Dylan0623/Rematch_in_2019/升压电路/升压模块12V转15V.pdf

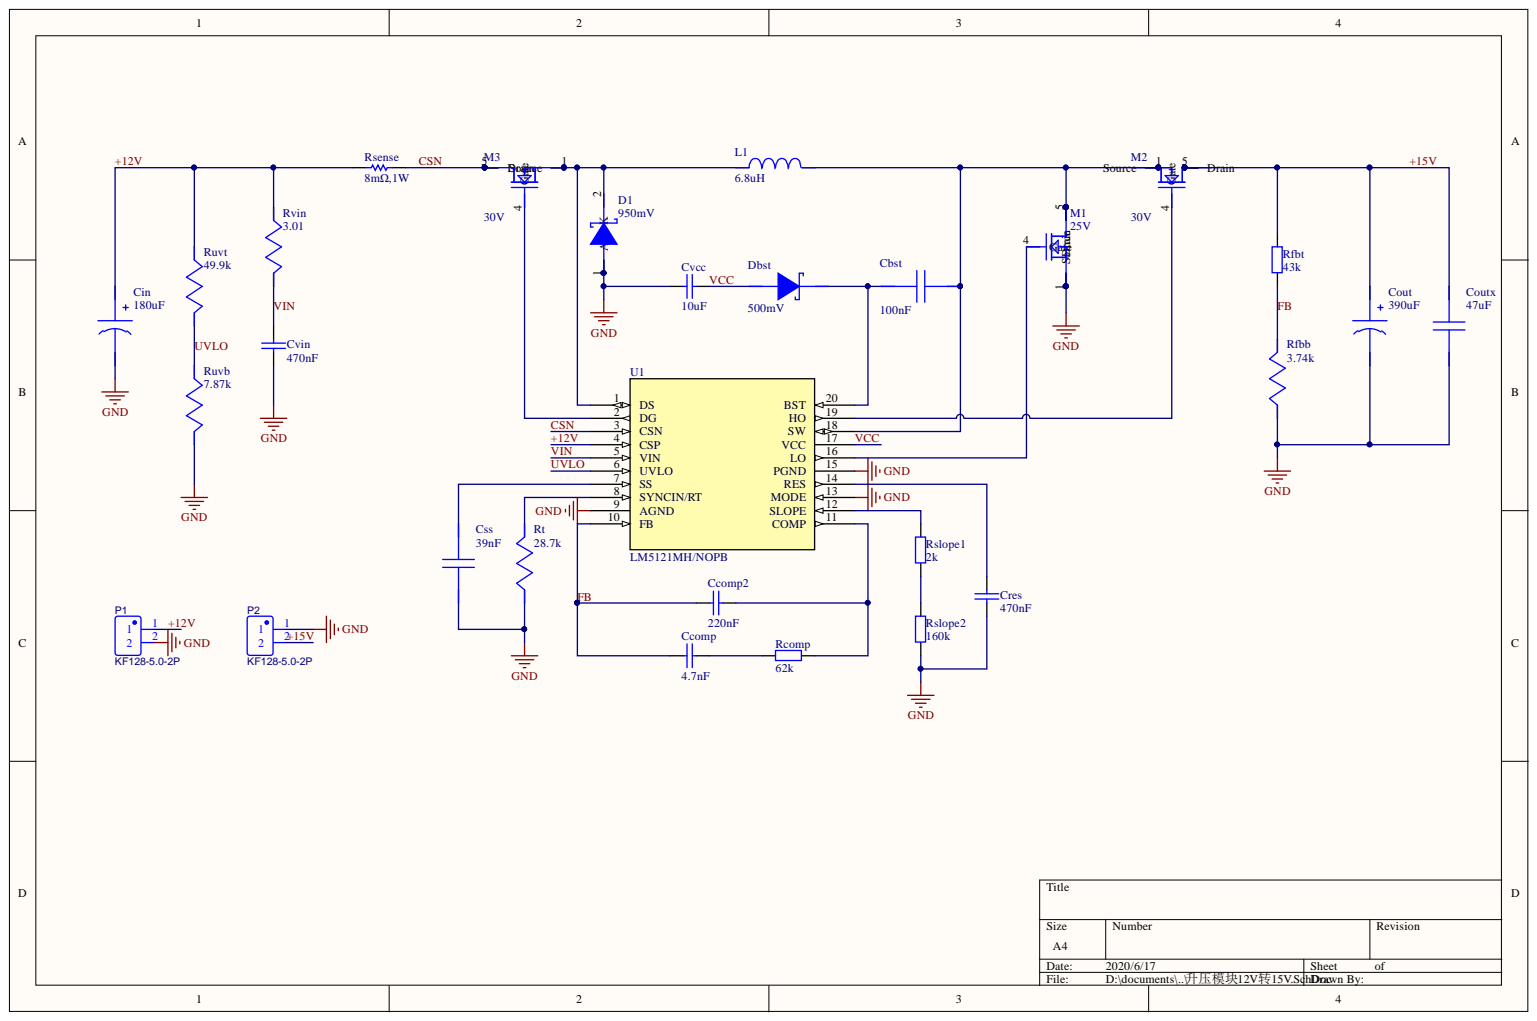
[picture p3: page 1]

FB | FB
