Dylan0623/Rematch_in_2019/电机驱动/电机驱动.pdf

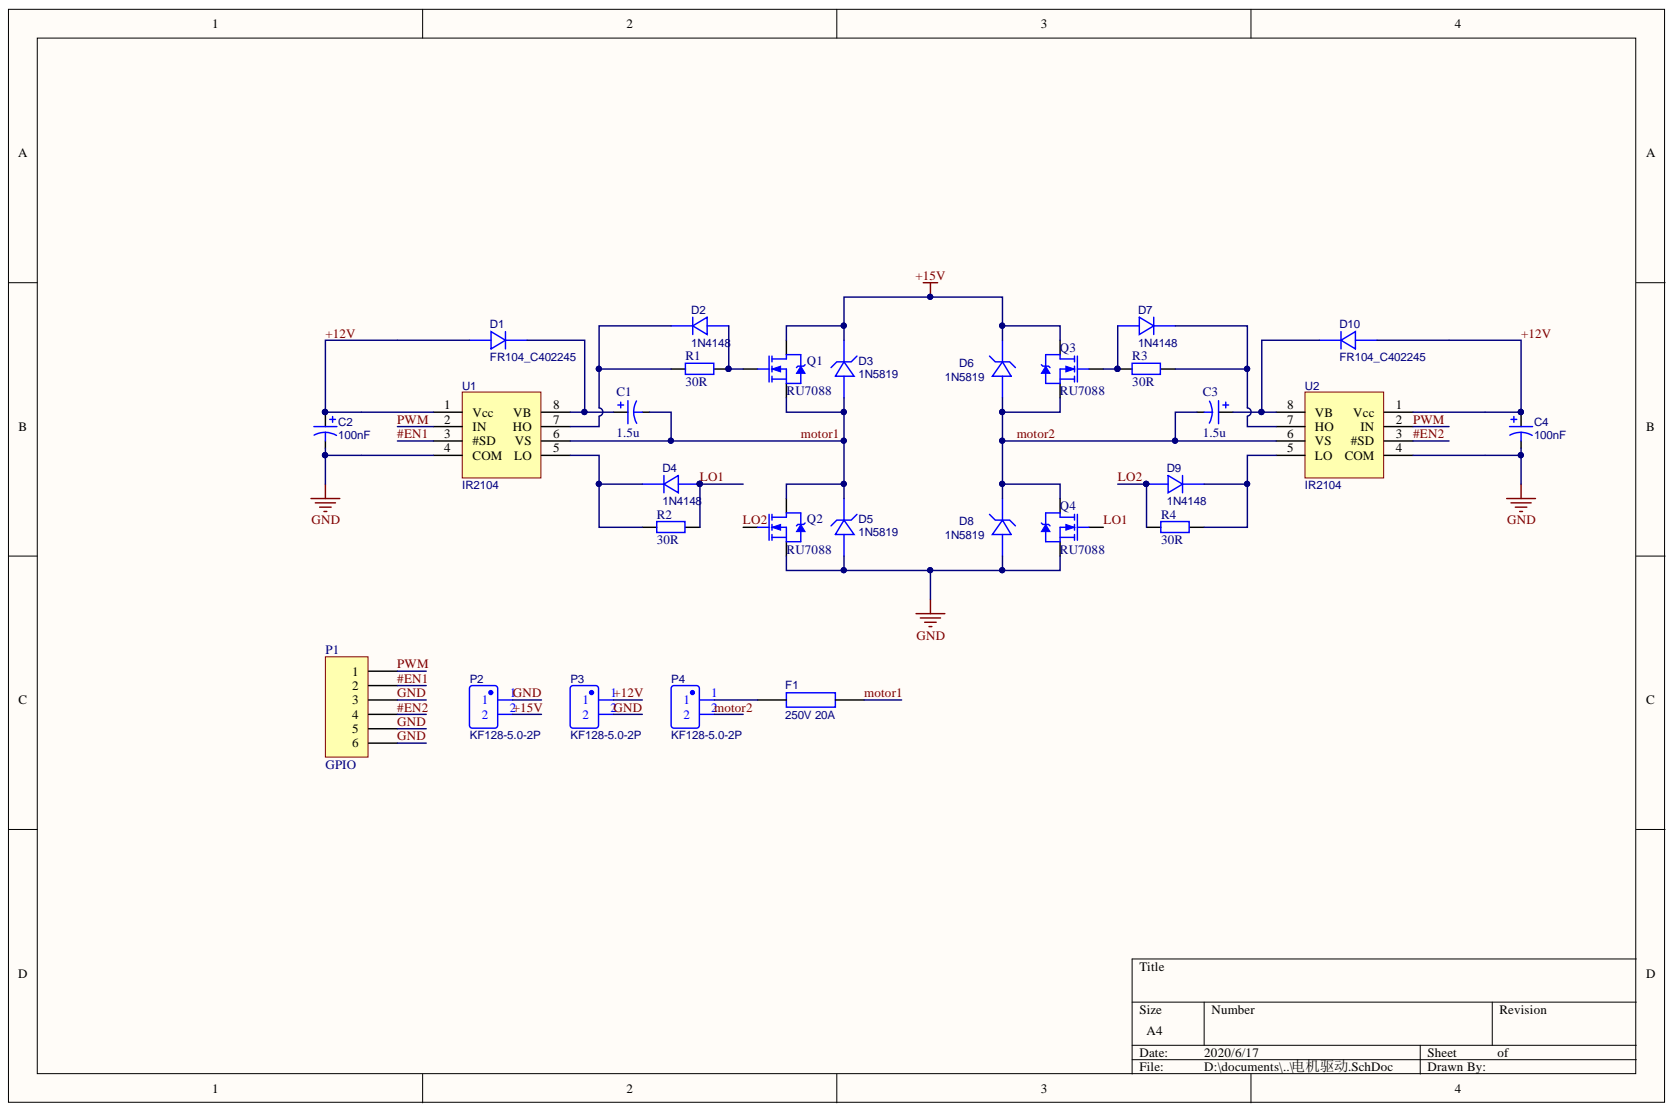
[picture p4: page 1]
