Dylan0623/Rematch_in_2019/电流脉冲检测电路/电流脉冲检测.pdf

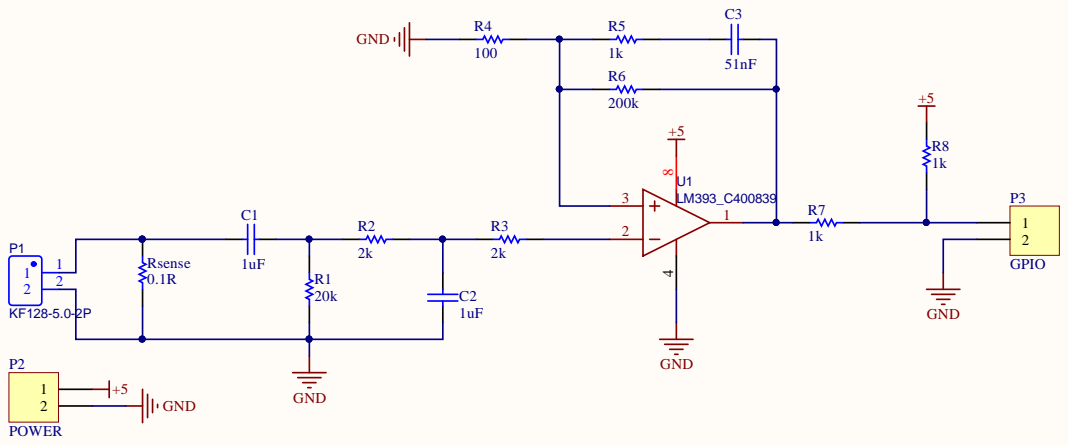
[picture p5: page 1]
