Dylan0623/Rematch_in_2019/(list of files, drawings)

Other design files:
升压电路/升压模块12V转15V.PcbDoc
升压电路/升压模块12V转15V.PrjPCB
升压电路/升压模块12V转15V.SchDoc
电机驱动/电机驱动.PcbDoc
电机驱动/电机驱动.PrjPCB
电机驱动/电机驱动.SchDoc
电流检测/INA282.PcbDoc
电流检测/INA282.SchDoc
电流检测/PCB_Project.PrjPcb
电流脉冲检测电路/电流脉冲检测.PcbDoc
电流脉冲检测电路/电流脉冲检测.PrjPCB
电流脉冲检测电路/电流脉冲检测.SchDoc
辅助电源/PCB2.PcbDoc
辅助电源/PCB_Project.PrjPcb
辅助电源/Sheet2.SchDoc
