Dylan0623/Rematch_in_2019/stm32/Src/main.c

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

/* Includes ------------------------------------------------------------------*/
#include "main.h"
#include "adc.h"
#include "tim.h"
#include "usart.h"
#include "gpio.h"

/* USER CODE BEGIN Includes */
#include <stdio.h>
#include "moto.h"
/* USER CODE END Includes */


/* USER CODE BEGIN PV */

int pwm_mode0 = 0;    		//pwm计数
int pwm_mode1_ang = 0;  	//pwm计数
int pwm_mode1_sp = 0;     //pwm计数
int mode = -1;            //模式0和1 -1为无操作
int target_speed = 5*390; //目标速度：脉冲/秒
int target_angel_1 = 160; //目标圈数
int target_angel_2 = 530; //目标圈数1m
int target_speed_1 = 0.3*390;
int uart_sent_times = 0;  //串口时间
int stateZF = 0;          //电机换向
float ADC = 0;       //ADC值 

/* USER CODE END PV */

void SystemClock_Config(void);
/* USER CODE BEGIN 0 */
int fputc(int ch, FILE *f){
	uint8_t temp[1] = {ch};
	HAL_UART_Transmit(&huart1, temp, 1, 2);//huart1需要根据你的配置修改
	return ch;
}
/* USER CODE END 0 */

/**
  * @brief  The application entry point.
  * @retval int
  */
int main(void)
{
  /* MCU Configuration--------------------------------------------------------*/

  /* Reset of all peripherals, Initializes the Flash interface and the Systick. */
  HAL_Init();

  /* Configure the system clock */
  SystemClock_Config();

  /* Initialize all configured peripherals */
  MX_GPIO_Init();
  MX_ADC1_Init();
  MX_TIM1_Init();
  MX_TIM2_Init();
  MX_USART1_UART_Init();
  /* USER CODE BEGIN 2 */
	HAL_TIM_Base_Start_IT(&htim1);
	HAL_ADCEx_Calibration_Start(&hadc1);
	
  /* USER CODE END 2 */

  /* Infinite loop */
  /* USER CODE BEGIN WHILE */
  while (1)
  {
    /* USER CODE END WHILE */

    /* USER CODE BEGIN 3 */
  }
  /* USER CODE END 3 */
}

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
/* USER CODE BEGIN 4 */

/*********************/
void BeforeSleep(void){                                         //休眠状态前准备
	__HAL_RCC_APB2_FORCE_RESET();
	__HAL_RCC_PWR_CLK_ENABLE();
	__HAL_PWR_CLEAR_FLAG(PWR_FLAG_WU);
	HAL_PWR_EnableWakeUpPin(PWR_WAKEUP_PIN1);
}

void SwitchZF(void){                                            //切换电机方向
	HAL_GPIO_WritePin(EN1_GPIO_Port,EN1_Pin,GPIO_PIN_SET);
	HAL_GPIO_WritePin(EN2_GPIO_Port,EN2_Pin,GPIO_PIN_SET);
	HAL_Delay(10);
	if(stateZF == 0){
		HAL_GPIO_WritePin(EN1_GPIO_Port,EN1_Pin,GPIO_PIN_SET);
		HAL_GPIO_WritePin(EN2_GPIO_Port,EN2_Pin,GPIO_PIN_RESET);
	}
	else if(stateZF == 1){
		HAL_GPIO_WritePin(EN1_GPIO_Port,EN1_Pin,GPIO_PIN_RESET);
		HAL_GPIO_WritePin(EN2_GPIO_Port,EN2_Pin,GPIO_PIN_SET);
	}
}

/*********************/
void HAL_GPIO_EXTI_Callback(uint16_t GPIO_Pin) {          
  if(GPIO_Pin == A_INTPUT_Pin) {                                //检测到电机AB相有上升沿或下降沿均计数一次，即4倍频
		if(mode == 0)
			pwm_mode0++;
  }
	
	else if(GPIO_Pin == B_INTPUT_Pin){                            //检测到电机AB相有上升沿或下降沿均计数一次，即4倍频
		if(mode == 0)
			pwm_mode0++;
	}
	
	else if(GPIO_Pin == Mode_Pin){
		HAL_Delay(10);                                               //消抖
		if(HAL_GPIO_ReadPin(Mode_GPIO_Port,Mode_Pin) == GPIO_PIN_SET){     //切换模式，题5
			mode = 0;
		}
		else if(HAL_GPIO_ReadPin(Mode_GPIO_Port,Mode_Pin) == SET){  //切换模式，题6
			mode = 1;
		}
	}
	
	else if(GPIO_Pin == SLEEP_MODE_Pin){                          //进入休眠状态
		HAL_Delay(3000);                                            //消抖、延迟
		if(HAL_GPIO_ReadPin(Mode_GPIO_Port,Mode_Pin) == GPIO_PIN_SET){
			BeforeSleep();
			HAL_PWR_EnterSTANDBYMode();
		}
	}
	
	else if(GPIO_Pin == CONTROL_I_Pin){                           //题6二倍频计数
		if(mode == 1)
			pwm_mode1_ang++;
			pwm_mode1_sp++;
	}
	else if(GPIO_Pin == Switch_ZF_Pin){                           //切换电机方向
		HAL_Delay(10);                                              //消抖、延迟
		if(HAL_GPIO_ReadPin(Mode_GPIO_Port,Mode_Pin) == GPIO_PIN_SET){
			stateZF = !stateZF;
			SwitchZF();
		}

	}
}

/*********************/
void HAL_TIM_PeriodElapsedCallback(TIM_HandleTypeDef *htim) {
	if (htim->Instance == htim1.Instance) {
		if(mode != -1){
			HAL_TIM_PWM_Start(&htim2,TIM_CHANNEL_1);                //启动PWM输出
			if(mode == 0){
				int pwm = (float)calculate_speed(pwm_mode0)/4.0;      //得到频率 除4为还原原频率
				pwm_mode0 = 0;																				//重置得速度
				float speed = pwm;                              //每圈390个脉冲
				mode_0(target_speed,speed);                           //模式0函数
				uint8_t speed_out = (float)((int)speed*100)/100.0;    //剩两位小数
			}
			else if(mode == 1){
				int pwm_ang = (float)calculate_speed(pwm_mode1_ang)/2.0;       //得到频率 除4为还原原频率
				float angel = pwm_ang/2.0;                                     //每圈2个脉冲
        int pwm_sp = (float)calculate_speed(pwm_mode1_sp)/2.0;         //得到频率 除4为还原原频率
				pwm_mode1_sp = 0;																				       //重置得速度
				float speed = pwm_sp/2.0;   
				mode_1(target_angel_1,target_angel_2,angel,target_speed_1,speed);            //模式1函数
			}
		}
		if(uart_sent_times == 100){
			HAL_ADC_Start(&hadc1);                             //启动ADC
			HAL_ADC_PollForConversion(&hadc1, 5);              //读取ADC数值，时间5ms  实际时间12Mhz/14
			ADC += HAL_ADC_GetValue(&hadc1);              //记录检测电流
			float ADCvalue = ADC*3.3/4096;                //求电压
			printf("%.4f/n",ADCvalue/5.0);										 //串口输出电流
			uart_sent_times = 0;
		}
//		else if(uart_sent_times > 96){
//			HAL_ADC_Start(&hadc1);                             //启动ADC
//			HAL_ADC_PollForConversion(&hadc1, 5);              //读取ADC数值，时间5ms  实际时间12Mhz/14
//			temp_ADC += HAL_ADC_GetValue(&hadc1);              //记录检测电流
//		}
	}
}

/* USER CODE END 4 */
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
