Dylan0623/Rematch_in_2019/stm32/Inc/main.h

#define Switch_ZF_Pin GPIO_PIN_13
#define Switch_ZF_GPIO_Port GPIOC
#define bb_Pin GPIO_PIN_1
#define bb_GPIO_Port GPIOA
#define Mode_Pin GPIO_PIN_2
#define Mode_GPIO_Port GPIOA
#define Mode_EXTI_IRQn EXTI2_IRQn
#define A_INTPUT_Pin GPIO_PIN_3
#define A_INTPUT_GPIO_Port GPIOA
#define A_INTPUT_EXTI_IRQn EXTI3_IRQn
#define B_INTPUT_Pin GPIO_PIN_4
#define B_INTPUT_GPIO_Port GPIOA
#define B_INTPUT_EXTI_IRQn EXTI4_IRQn
#define ADC_Pin GPIO_PIN_5
#define ADC_GPIO_Port GPIOA
#define CONTROL_I_Pin GPIO_PIN_6
#define CONTROL_I_GPIO_Port GPIOA
#define CONTROL_I_EXTI_IRQn EXTI9_5_IRQn
#define SLEEP_MODE_Pin GPIO_PIN_1
#define SLEEP_MODE_GPIO_Port GPIOB
#define PWM_OUT_Pin GPIO_PIN_15
#define PWM_OUT_GPIO_Port GPIOA
#define EN1_Pin GPIO_PIN_8
#define EN1_GPIO_Port GPIOB
#define EN2_Pin GPIO_PIN_9
#define EN2_GPIO_Port GPIOB
